kfjodor/BottomHeater/KiCad/BottomHeater.kicad_pcb

## KiCad design KiCad/BottomHeater.kicad_pcb (2025-01-05)

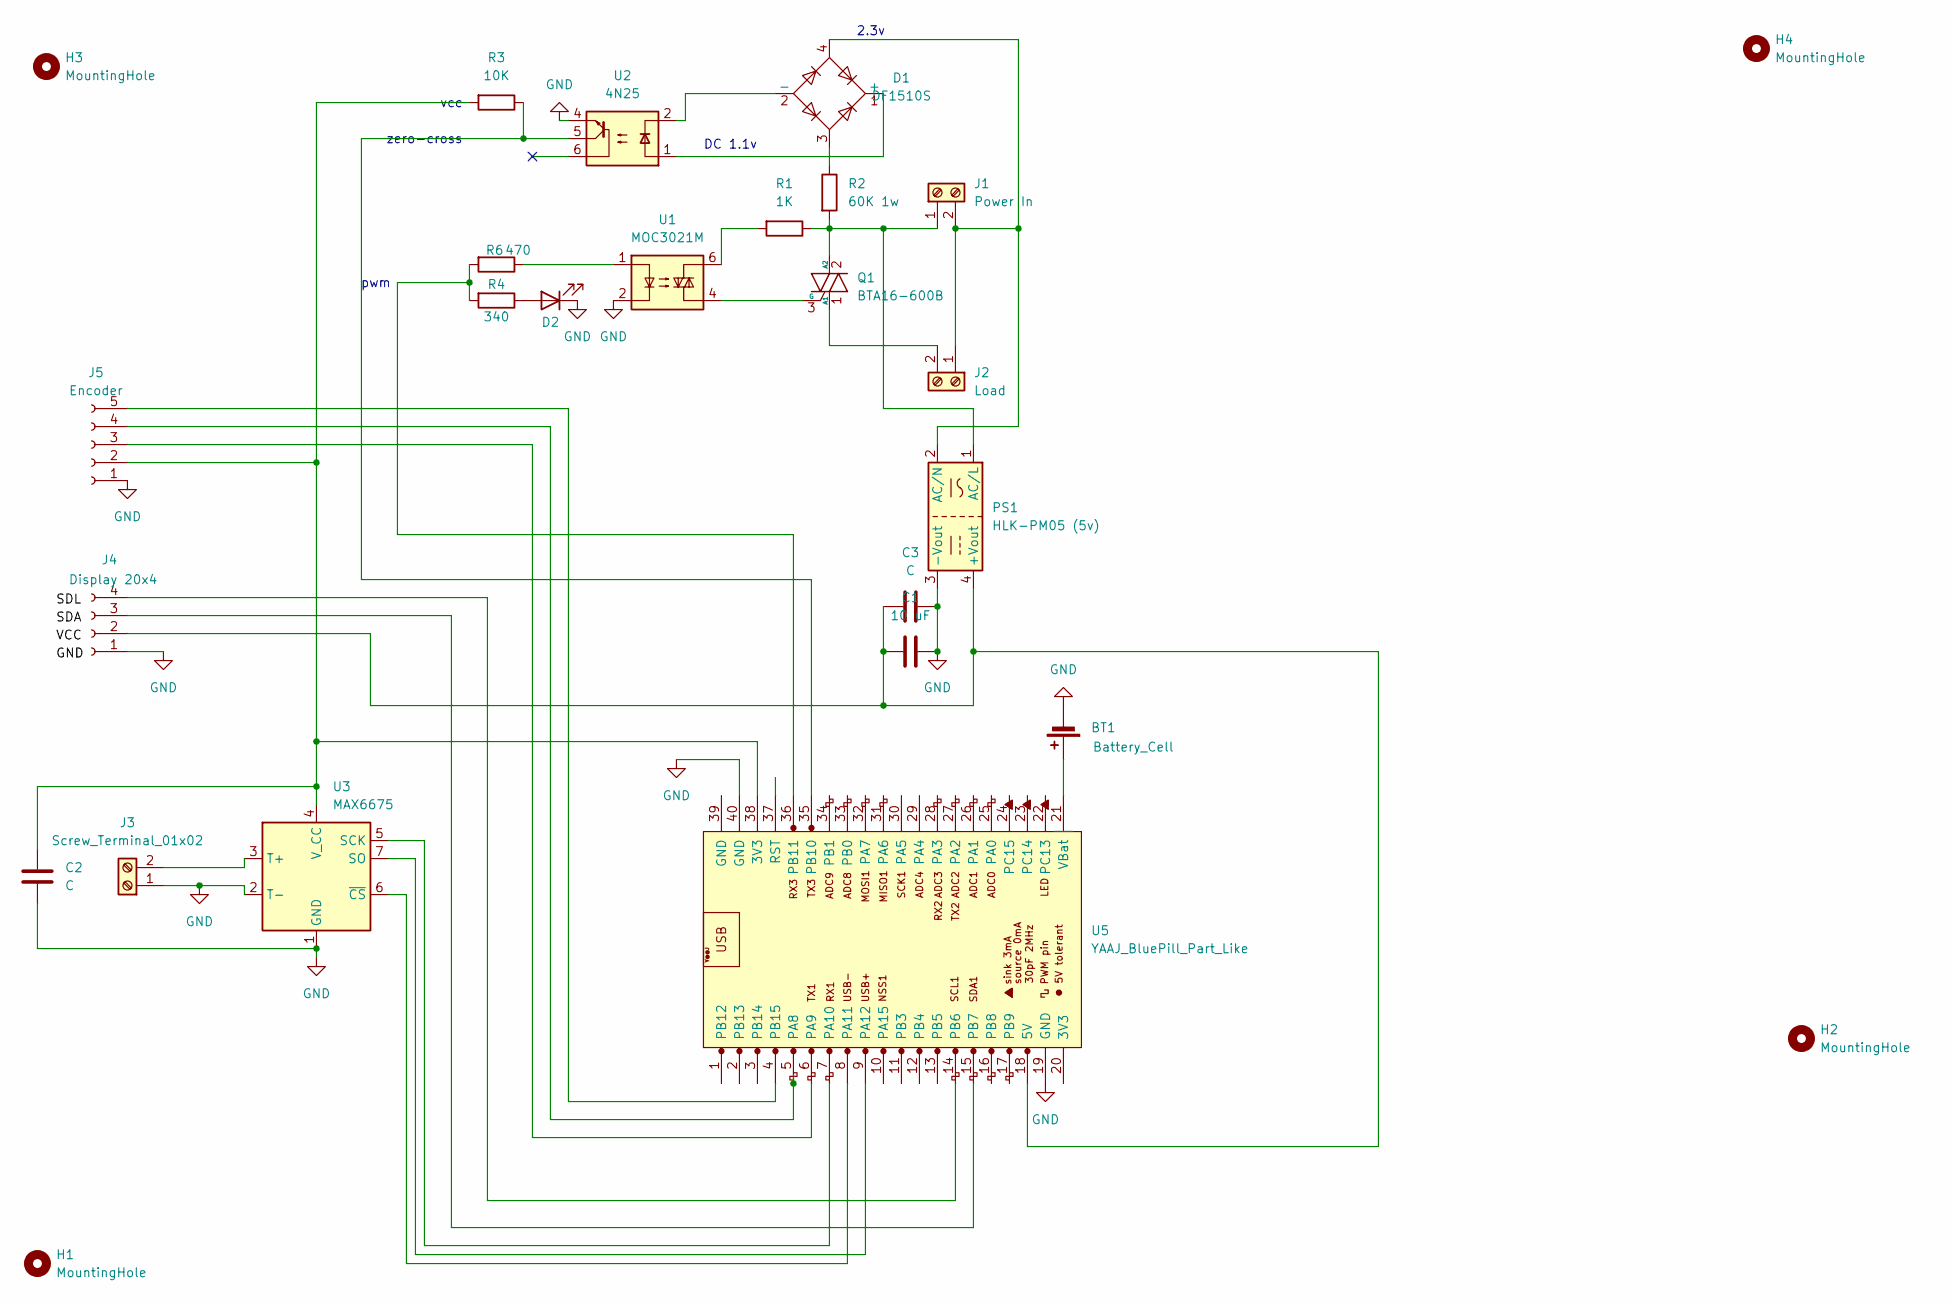
[picture p1: schematic BottomHeater.kicad_sch]

Parts:
BT1: Battery_Cell; Battery_Panasonic_CR2032-HFN_Horizontal_CircularHoles
C1: 10 uF; C_0603_1608Metric
C2: C; C_0603_1608Metric
C3: C; C_Radial_D5.0mm_H5.0mm_P2.00mm
D1: DF1510S; Diode_Bridge_OnSemi_SDIP-4L
D2: LED; LED_D3.0mm
H1, H2, H3, H4: MountingHole; MountingHole_2mm
J1: Power In; TerminalBlock_MaiXu_MX126-5.0-02P_1x02_P5.00mm
J2: Load; TerminalBlock_MaiXu_MX126-5.0-02P_1x02_P5.00mm
J3: Screw_Terminal_01x02; PhoenixContact_GMSTBVA_2,5_2-G-7,62_1x02_P7.62mm_Vertical
J4: Display 20x4; Molex_KK-254_AE-6410-05A_1x05_P2.54mm_Vertical
J5: Encoder; Molex_KK-254_AE-6410-05A_1x05_P2.54mm_Vertical
PS1: HLK-PM05 (5v); Converter_ACDC_Hi-Link_HLK-PMxx
Q1: BTA16-600B; TO-220-3_Vertical
R1: 1K; R_Axial_DIN0309_L9.0mm_D3.2mm_P15.24mm_Horizontal
R2: 60K 1w; R_Axial_DIN0309_L9.0mm_D3.2mm_P15.24mm_Horizontal
R3: 10K; R_1206_3216Metric
R4: 340; R_1206_3216Metric
R6: 470; R_1206_3216Metric
U1: MOC3021M; DIP-6_W7.62mm
U2: 4N25; DIP-6_W7.62mm
U3: MAX6675; SOIC-8_3.9x4.9mm_P1.27mm
U5: YAAJ_BluePill_Part_Like; YAAJ_BluePill_1

Connections:
GND: BT1.2 (-), C1.1, C2.2, C3.1, D2.1 (K), J3.1, J4.1, J5.1, PS1.3 (-Vout), U1.2, U2.4, U3.1 (GND), U3.2 (T-), U5.19 (GND), U5.40 (GND)
unnamed: BT1.1 (+), U5.21 (VBat)
unnamed: D1.1 (+), U2.1
unnamed: D1.2 (-), U2.2
unnamed: D1.3, R2.1
unnamed: D2.2 (A), R4.1
unnamed: J1.1, PS1.1 (AC/L), Q1.2 (A2), R1.1, R2.2
unnamed: D1.4, J1.2, J2.1, PS1.2 (AC/N)
unnamed: J2.2, Q1.1 (A1)
unnamed: J3.2, U3.3 (T+)
unnamed: C1.2, C3.2, J4.2, PS1.4 (+Vout), U5.18 (5V)
unnamed: J4.3, U5.15 (PB7)
unnamed: J4.4, U5.14 (PB6)
unnamed: C2.1, J5.2, R3.2, U3.4 (V_CC), U5.38 (3V3)
unnamed: J5.3, U5.6 (PA9)
unnamed: J5.4, U5.5 (PA8)
unnamed: J5.5, U5.4 (PB15)
unnamed: Q1.3 (G), U1.4
unnamed: R1.2, U1.6
unnamed: R6.1, U1.1
unnamed: U3.5 (SCK), U5.7 (PA10)
unnamed: U3.7 (SO), U5.9 (PA12)
unnamed: U3.6 (~CS), U5.8 (PA11)
unnamed: R3.1, U2.5, U5.35 (PB10)
unnamed: R4.2, R6.2, U5.36 (PB11)

Notes on the sheet:
pwm
DC 1.1v
vcc
2.3v
zero-cross

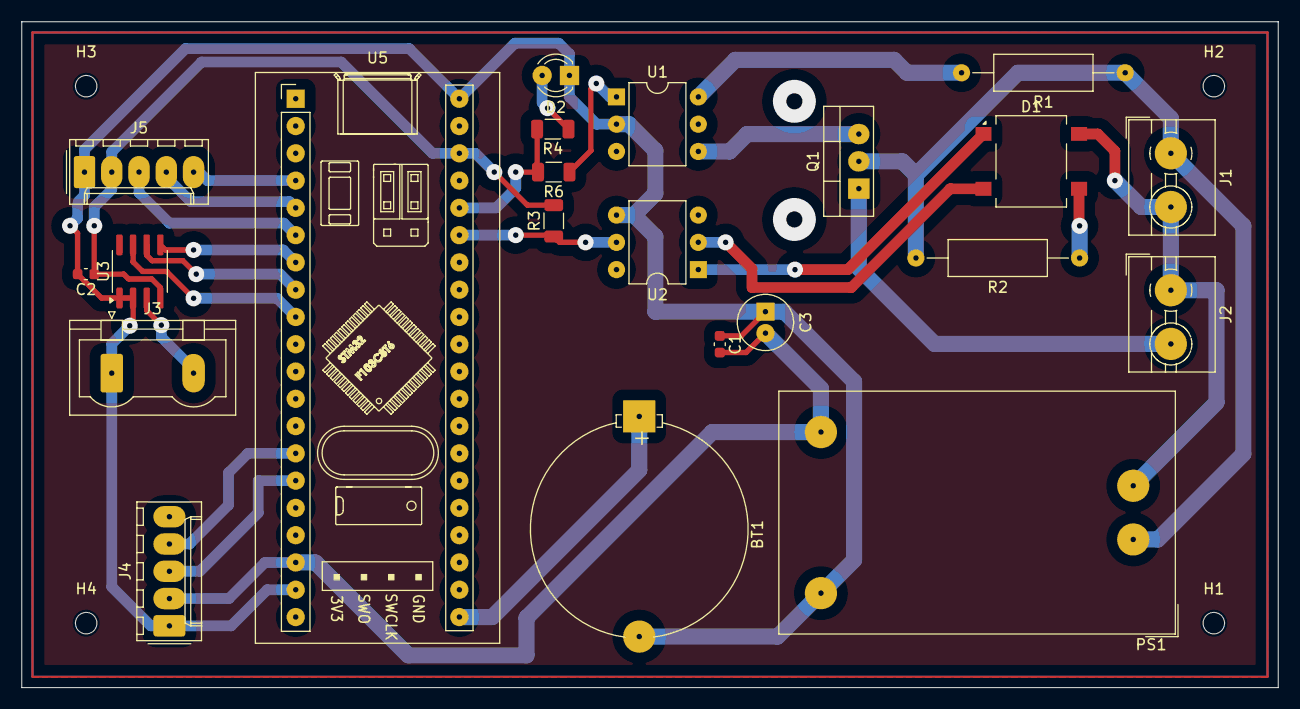
[picture p2: board BottomHeater.kicad_pcb from above]

Board: 2 copper layers, 117.0 x 62.0 mm, 26 parts (0 on the bottom side), 25 nets.
