kfjodor/BottomHeater/BottomHeater.ino

#include <HardwareTimer.h>
#include <Wire.h>
#include <LiquidCrystal_I2C.h>
#include <max6675.h>

#define MODE_TEMP 1
#define MODE_POWER 2

#define MAXCLK PA10
#define MAXCS PA11
#define MAXDO PA12

#define ENCODER_S1 PB15  //PB13
#define ENCODER_S2 PA8   //PB14
#define ENCODER_KEY PA9  //PB15

#define TRIAC_ZERO_CROSS PB10
#define TRIAC_PWM PB11

MAX6675 thermocouple(MAXCLK, MAXCS, MAXDO);
LiquidCrystal_I2C lcd(0x27, 16, 2);  // set the LCD address to 0x27 for a 16 chars and 2 line display
HardwareTimer outTimer(TIM3);

int mode = MODE_TEMP;
float temp = 0;
float prevTemp = 0;
float prevTemp3sec = 0;
unsigned long prevMillis = 0;

int count = 0;
float heat_eff = 0;
int desiredTemp = 0;
bool tempChanged = false;
volatile int power = 20;  // 0 - 100
bool powerChanged = false;
int powerDelay = 0;  // 1-9999 for 50Hz
const int measurementCycles = 3;
unsigned long prevRotation = 0;

void setup() {
  lcd.init();
  lcd.init();
  lcd.backlight();

  desiredTemp = thermocouple.readCelsius();

  pinMode(ENCODER_S1, INPUT_PULLUP);
  pinMode(ENCODER_S2, INPUT_PULLUP);
  pinMode(ENCODER_KEY, INPUT_PULLUP);
  pinMode(TRIAC_ZERO_CROSS, INPUT);
  pinMode(TRIAC_PWM, OUTPUT);

  // Button pressed on start
  if (digitalRead(ENCODER_KEY) == LOW) {
    mode = MODE_POWER;
  }

  attachInterrupt(digitalPinToInterrupt(TRIAC_ZERO_CROSS), ZeroCross, RISING);
  attachInterrupt(digitalPinToInterrupt(ENCODER_S1), EncoderRotate, FALLING);
  //attachInterrupt(digitalPinToInterrupt(ENCODER_KEY), EncoderKey, FALLING);

  printPower(power, heat_eff);
}

void printTemp(float temp1, int temp2) {
  lcd.setCursor(0, 0);
  lcd.print("                ");
  lcd.setCursor(0, 0);
  if (mode == MODE_TEMP) {
    lcd.print("*");
  }
  lcd.print(temp1);

  if (int(temp1) == temp2) {
    lcd.print(" == ");
  } else {
    lcd.print(" -> ");
  }

  lcd.print(temp2);
}

void printPower(int power, float heat_eff) {
  lcd.setCursor(0, 1);
  lcd.print("                ");
  lcd.setCursor(0, 1);
  if (mode == MODE_POWER) {
    lcd.print("*");
  }
  lcd.print("P:" + String(power) + "% ");
  lcd.print("E:" + String(heat_eff, 1));
}

void timerTriac() {
  digitalWrite(TRIAC_PWM, HIGH);
}

void ZeroCross() {
  digitalWrite(TRIAC_PWM, LOW);

  outTimer.pause();
  outTimer.attachInterrupt(timerTriac);
  outTimer.setOverflow(powerDelay, MICROSEC_FORMAT);
  outTimer.refresh();
  outTimer.resume();
}

void EncoderRotate() {
  if (mode == MODE_TEMP) {
    EncoderRotateTemp();
  } else {
    EncoderRotatePower();
  }
}

void EncoderKey() {
  if (mode == MODE_TEMP) {
    EncoderKeyTemp();
  } else {
    EncoderKeyPower();
  }
}

void EncoderRotateTemp() {
  unsigned long changeValue = 1;
  unsigned long currentRotation = micros();

  if (currentRotation - prevRotation < 10000) {
    changeValue = 20;
  } else if (currentRotation - prevRotation < 20000) {
    changeValue = 10;
  }

  prevRotation = currentRotation;

  if (digitalRead(ENCODER_S1) == LOW && digitalRead(ENCODER_S2) == LOW) {
    desiredTemp += changeValue;
  } else if (digitalRead(ENCODER_S1) == LOW && digitalRead(ENCODER_S2) == HIGH) {
    desiredTemp -= changeValue;
  }

  if (desiredTemp < 0) {
    desiredTemp = 0;
  }

  tempChanged = true;
}

void EncoderKeyTemp() {
  desiredTemp += 10;
  tempChanged = true;
}

void EncoderRotatePower() {
  if (digitalRead(ENCODER_S2) == LOW) {
    power++;
  } else {
    power--;
  }

  // noInterrupts failed on stm32 on main loop so checking here
  if (power > 100) {
    power = 100;
  } else if (power < 0) {
    power = 0;
  } else {
    powerChanged = true;
  }
}

void EncoderKeyPower() {
  power += 10;

  // noInterrupts failed on stm32 on main loop so checking here
  if (power > 100) {
    power = 100;
  } else if (power < 0) {
    power = 0;
  }

  powerChanged = true;
}

void setPowerDelay(int power) {
  powerDelay = (100 - power) * 100;
}

void loopPower() {
  unsigned long nowMillis = millis();

  if (prevMillis + 1000 < nowMillis) {
    temp = thermocouple.readCelsius();
    if (temp != prevTemp) {
      tempChanged = true;
      prevTemp = temp;
      printTemp(temp, 0);
    }

    prevMillis = nowMillis;
    count++;

    // 3 секундный счетчик
    if (count == measurementCycles) {
      heat_eff = temp - prevTemp3sec;  // скорость нагрева в 3 секунд
      prevTemp3sec = temp;
      count = 0;
      printPower(power, heat_eff);
    }
  }

  if (powerChanged) {
    setPowerDelay(power);
    printPower(power, heat_eff);
    powerChanged = false;
  }
}

float heat_eff_min;
float heat_eff_max;

void loopTemp() {
  unsigned long nowMillis = millis();

  // каждые 1 сек обновляем температуру
  if (prevMillis + 1000 < nowMillis) {
    temp = thermocouple.readCelsius();
    if (temp != prevTemp) {
      tempChanged = true;
      prevTemp = temp;
    }

    prevMillis = nowMillis;

    count++;

    // 3 sec loop
    if (count == measurementCycles) {
      count = 0;
      heat_eff = temp - prevTemp3sec;
      prevTemp3sec = temp;

      // нагрев
      if (desiredTemp > temp) {
        float diff = desiredTemp - temp;
        if (diff > 50) {
          power = diff / 2;
        } else {
          heat_eff_min = diff / 15;
          heat_eff_max = diff / 10;

          if (heat_eff < heat_eff_min) {
            power++;
          }
          if (heat_eff > heat_eff_max) {
            power--;
          }
        }
      } else if (desiredTemp < temp) {  // охлаждение
        if (heat_eff > 0) {
          power--;
        }
      } else {  // Required temp acquired
        if (heat_eff > 0.5) {
          power--;
        } else if (heat_eff < 0.5) {
          power++;
        }
      }

      if (power > 100) {
        power = 100;
      } else if (power < 0) {
        power = 0;
      }

      setPowerDelay(power);
      printPower(power, heat_eff);
    }  // measurementCycles
  }    // 1 sec loop

  // покрутили ручку или произошел нагрев
  if (tempChanged) {
    printTemp(temp, desiredTemp);
    tempChanged = false;
  }
}

void loop() {
  if (mode == MODE_TEMP) {
    loopTemp();
  } else if (mode = MODE_POWER) {
    loopPower();
  }
}
