kfjodor/BottomHeater/(commit log)

2024-09-24 work in progress
    [BottomHeater.kicad_sch]
2024-12-04 board almost done
    [BottomHeater.kicad_pcb, BottomHeater.kicad_sch]
2024-12-19 heating algorithm experiment
2025-01-05 add KiCad project
    [BottomHeater.kicad_pcb, BottomHeater.kicad_sch]
